EngYork/RexFuzz/1.png

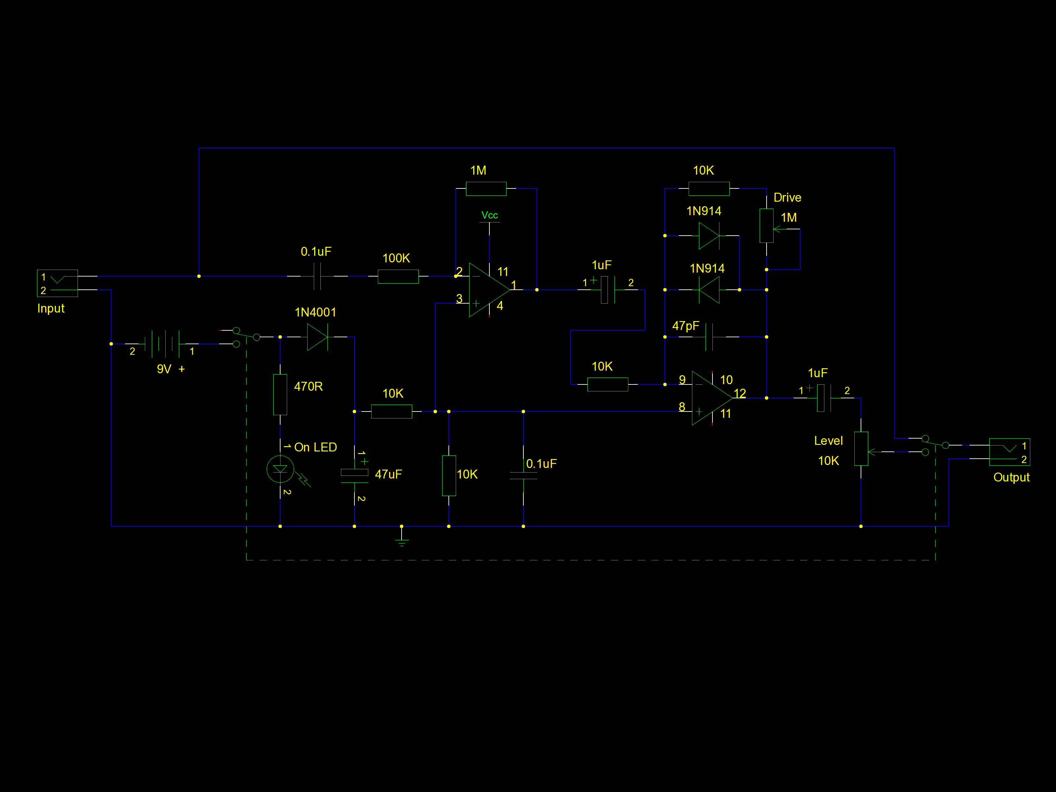
1.png
