EngYork/RexFuzz/LaTeX/DSCF7300.JPG

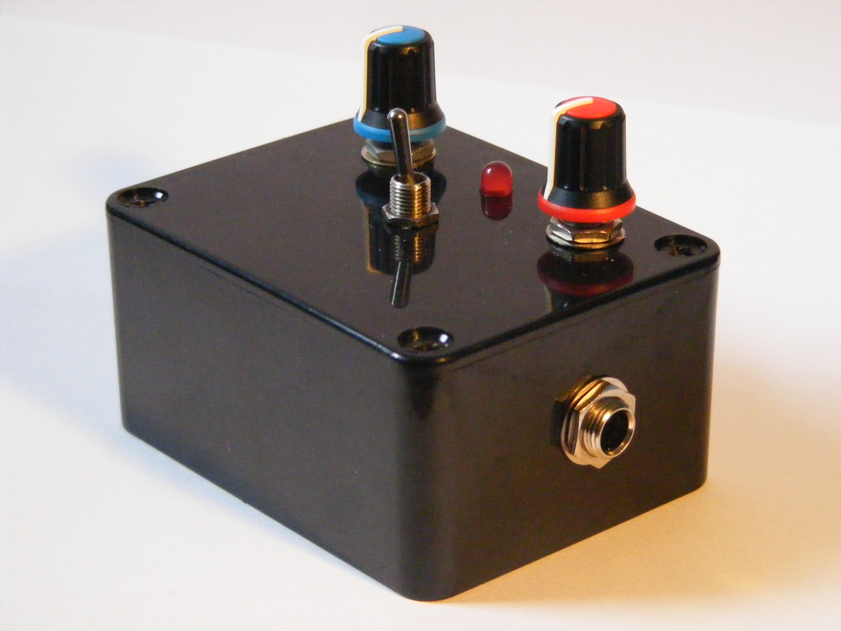
LaTeX/DSCF7300.JPG
