EngYork/RexFuzz/LaTeX/DSCF7301.JPG

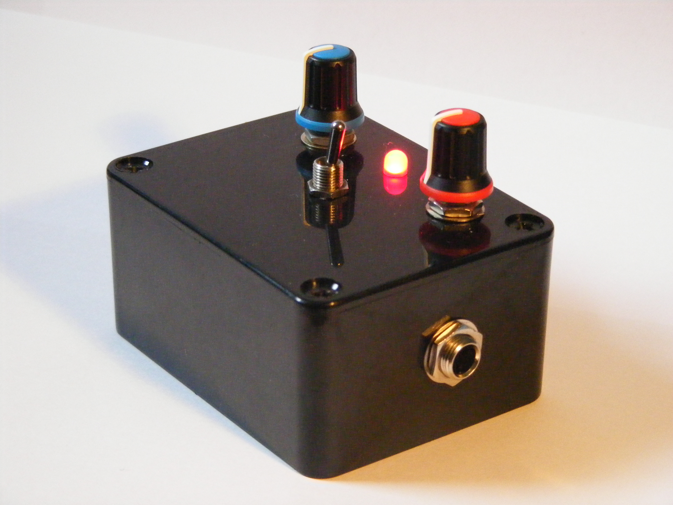
LaTeX/DSCF7301.JPG
