EngYork/RexFuzz/components.ods

OBSELETE: PLEASE USE STOCK SHEET ON GOOGLE DRIVE |  |  |  | Units
 | Component | Details | Site | part no. | Units | Price inc vat | Value on veroboard
 | Resistors | 10K | Rapid | 62-0394 | 4 | 0.03888 | R3, R4, R5, R6
 | Resistors | 100K | Rapid | 62-0418 (http://www.rapidonline.com/Electronic-Components/100k-Cr25-0-25w-Cf-Resistor-Pack-of-100-62-0418) | 1 | 0.03888 | R1
 | Resistors | 470R | Rapid | 62-0362 (http://www.rapidonline.com/Electronic-Components/470r-Cr25-0-25w-Cf-Resistor-Pack-of-100-62-0362) | 1 | 0.03888 | R7 | For on LED
 | Resistors | 1M | Rapid | 62-0442 (http://www.rapidonline.com/Electronic-Components/1m-Cr25-0-25w-Cf-Resistor-Pack-of-100-62-0442) | 1 | 0.03888 | R2
 | Capacitor | 0.1uF | Rapid | 11-3442 (http://www.rapidonline.com/Electronic-Components/0-1uF-10-100V-X7R-P-2-54mm-Suntan-Radial-Ceramic-Capacitor-11-3442) | 2 | 0.0432 | C1, C5
 | Capacitor | 47pF | Rapid | 11-3429 (http://www.rapidonline.com/Electronic-Components/47pF-5-100V-NPO-P-2-54mm-Suntan-Radial-Ceramic-Capacitor-11-3429) | 1 | 0.018 | C3
 | Capacitor | 1uF | Rapid | 11-1518 (http://www.rapidonline.com/Electronic-Components/1uf-50v-5mm-Micromin-Electro-Capacitor-11-1518) | 2 | 0.03912 | C2, C4
 | Capacitor | 47uF | Rapid | 11-1510 | 1 | 0.0528 | C6
 | Op-amp | LM358AN | Rapid | 82-0332 | 1 | 0.1548
 | Panel socket | 6.35mm Jack | Rapid | 20-0134 (http://www.rapidonline.com/Cables-Connectors/6-35mm-Panel-Mount-Open-Jack-Socket-20-0134) | 2 | 0.8352
 | LED | Red | Rapid | 55-0155 (http://www.rapidonline.com/Electronic-Components/Kingbright-L-7113ID-5mm-2V-Red-Diffused-LED-45mcd-55-0155) | 1 | 0.0492
 | Diode | 1N914 | Rapid | 47-3116 | 2 | 0.02376 | D1, D2
 | Diode | 1N4001 | Rapid | 50-0381 | 1 | 0.0144 | D3
 | IC holder | 8 pin | Rapid | 22-0107 (http://www.rapidonline.com/Cables-Connectors/Tube-of-60-8pin-DIL-Socket-Narrow-7-62mm-Without-Central-Support-22-0107) | 1 | 0.08232
 | Batter connector | PP3 | Rapid | 18-0163 | 1 | 0.18
 | Panel Pot | 1M | Rapid | 65-0745 | 1 | 0.3924
 | Panel Pot | 10K | Rapid | 65-0715 (http://www.rapidonline.com/Electronic-Components/10K-16mm-Linear-Potentiometer-65-0715) | 1 | 0.3924
 | Switch | Stomp (maybe?) | Rapid | 78-0744 (http://www.rapidonline.com/Electronic-Components/DPDT-Latching-Action-Foot-Switch-78-0744) | 1 | 1.536 |  | Must be LATCHING!
 | Box | 125.2x63.2x39 | Rapid | 30-3362 (http://www.rapidonline.com/Mechanical-Fastenings-Fixings/ABS-Box-Multipurpose-130-X-68-X-44-30-3362) | 1 | 1.5
 | Pot Dials | Nice! | Rapid | 32-1836 | 2 | 1.296
 | Stripboard | 4 per sheet | Rapid | 34-0515 | 0.25 | 0.2979
 | Heat Shrink | 3mm to 1mm | Rapid | 03-0850 | 0.25 | 0.1137
 |  |  |  |  |  | 0
 |  |  |  |  |  | 0
 |  |  |  |  |  | 0
 |  |  |  |  |  | 7.17672
